jriisbovbjerg/esp32-compass/enclosure/sensor_box_base.step

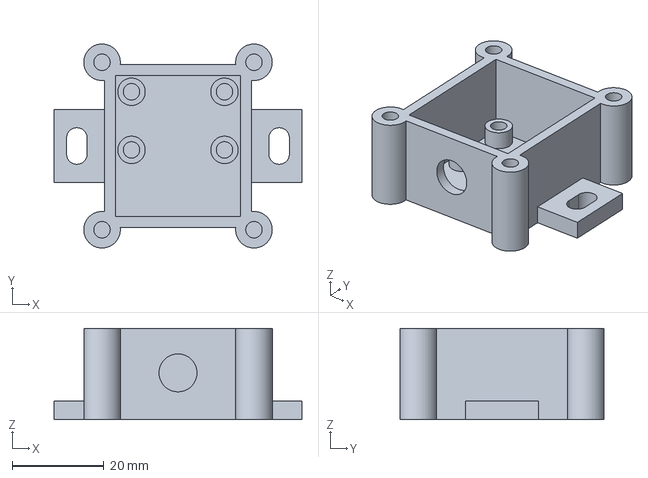
[picture p3: CAD file, 2026-10-17]
enclosure/sensor_box_base.step
54.2 x 44.6 x 19.9 mm
