jriisbovbjerg/esp32-compass/enclosure/sensor_box.FCStd

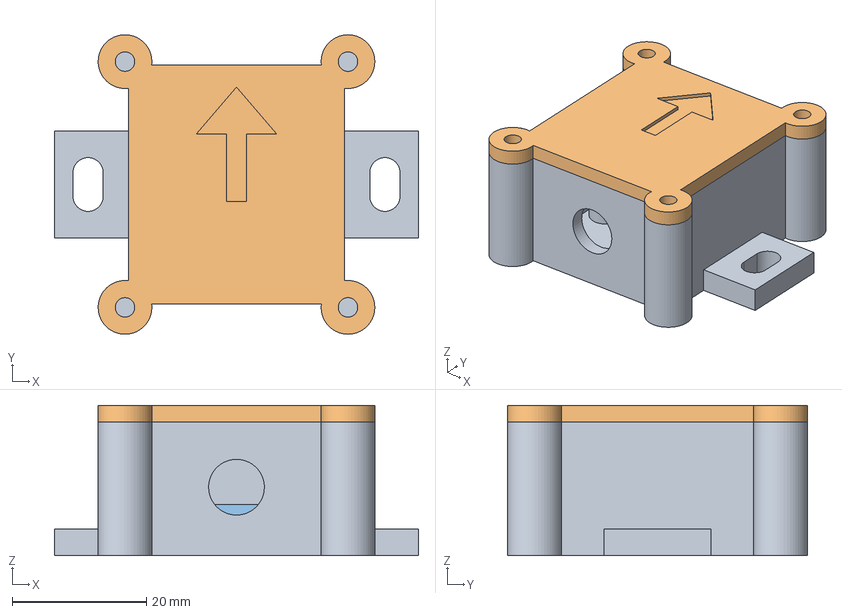
[picture p4: CAD file, 2026-10-17]
enclosure/sensor_box.FCStd
54.2 x 44.6 x 22.4 mm
Base
Lid
ICM20948_board
