jriisbovbjerg/esp32-compass/enclosure/sensor_box_lid.step

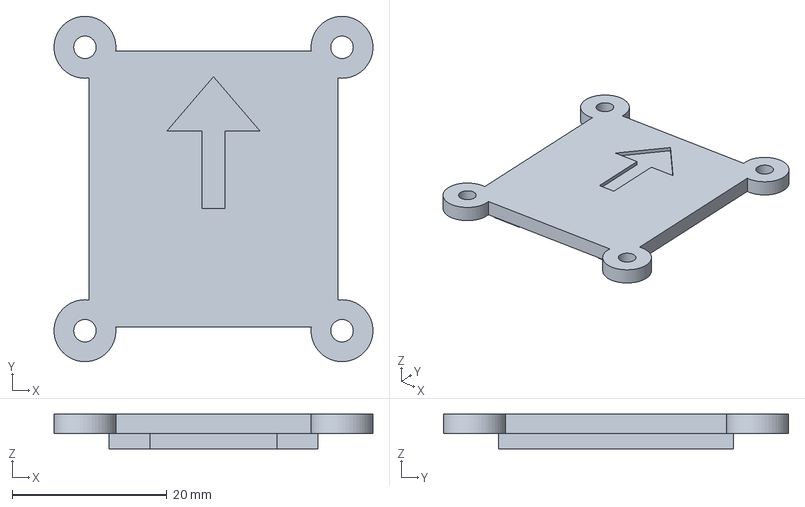
[picture p5: CAD file, 2026-10-17]
enclosure/sensor_box_lid.step
41.2 x 44.6 x 4.50 mm
