jriisbovbjerg/esp32-compass/(list of files, cad)

Other CAD files:
enclosure/sensor_box_base.stl
enclosure/sensor_box_lid.stl
