jriisbovbjerg/esp32-compass/(commit log)

2025-10-26 Initial commit: ESP32 compass with ICM-20948 sensor
2025-10-27 Fix temperature reading bug: swap temp and mag parameters in getEvent()
    [main.cpp]
2026-04-04 Add NEO-7M GPS: position, SOG, COG, datetime, satellite count
    - Wire GPS on UART2 (RX=GPIO16, TX=GPIO17) at 9600 baud
    - Publish navigation.position, speedOverGround, courseOverGroundTrue
    - Suppress COG below 0.5 km/h (meaningless when stationary)
    - Publish navigation.datetime for SignalK/NMEA timestamp chain
    - Publish navigation.gnss.satellites for NMEA GGA quality field
    - Add HTTP /status endpoint with GPS fix, sats, lat/lng, SOG, COG
    - Add TinyGPSPlus dependency to platformio.ini
    [main.cpp]
2026-04-18 Fix WiFi/SignalK reconnect robustness; add publish_age_s to /status
    - server.begin() now called only after WiFi connects (prevents boot crash
    when WiFi fails at startup)
    - WiFi watchdog re-initialises mDNS, OTA, HTTP server and SignalK on
    reconnect after a dropout
    - /status reports publish_age_s: seconds since last successful SignalK
    publish (-1 if never published)
    [main.cpp]
2026-04-21 Add NVS calibration persistence and boat-calibration workflow
    - Remove auto-calibration on boot (was cause of stuck heading)
    - Add Preferences/NVS save+load for magnetometer hard-iron offsets
    - Calibration now triggered via GET /calibrate/start; user motors 2
    full circles, then GET /calibrate/stop to save (min 200 samples)
    - 10-minute safety timeout auto-saves if stop is never called
    - /status shows cal_running, cal_elapsed_s, cal_samples, cal_ready
    - No heading published until calibrated; GPS still feeds SignalK
    [main.cpp]
2026-08-30 Add WS heartbeat to catch half-open SignalK connections
    ws.enableHeartbeat() detects a stuck-but-connected WS session at the
    protocol layer (ping/pong) instead of relying on a publish-timeout
    timer, and lets the existing reconnect logic handle it - no restart
    needed. Same fix as temperature_monitor/battery_monitor; no DS18B20
    sensors here so no self-heal counterpart needed.
    Not yet deployed - this unit is currently in the lab, off the boat
    network. Build verified locally only.
    [main.cpp]
2026-09-26 Rewrite README: hardware, power, wiring, SignalK paths, calibration, prototype photos
2026-10-17 Add parametric FreeCAD sensor box enclosure (base + lid)
